OffSetEyeBrow/T-Minus-Case/README.md

# T-Minus-Case



Metalic Case for The E-ink smartwatch Yatchy.

Here you'll find in depth information to manufacture top and bottom case, internal spacers, isolating layers for the internals and buttons.

---

##  Repository Structure

Inside this repository i have made available blueprints with tolerances and GD&T, CAD, CAM and STLs Files, and manufactiring process specificiations for all parts. For purchased parts i will leave a link to purchase or get in contact with the given maker.

###  Parts List and Links:
*   **[Top Case](https://github.com/OffSetEyeBrow/T-Minus-Case/tree/main/Top%20Case):** Machined, containing files and instructions on production
*   **[Bottom Case](https://github.com/OffSetEyeBrow/T-Minus-Case/tree/main/Bottom%20Case):** Machined, containing files and instructions on production
*   **[Internal Spacers](https://github.com/OffSetEyeBrow/T-Minus-Case/tree/main/Internals):** 3D Printed (FDM), containing files and 3D printing parameters
*   **[Buttons](https://github.com/OffSetEyeBrow/T-Minus-Case/tree/main/Buttons):** 3D Printed (FDM), containing files and 3D printing parameters
*   **[Yatchy Board](https://github.com/OffSetEyeBrow/T-Minus-Case/wiki):** Link to the Github of the original creator, still getting updated at the moment of writing this
*   **[Watch Strap](https://github.com/OffSetEyeBrow/T-Minus-Case/wiki):** Purchased from Aliexpress, brushed stainless steel with butterfly lock

###  Other Parts of the Repository:

*   **[Assembly](https://github.com/OffSetEyeBrow/T-Minus-Case/tree/main/Assembly):** Assembly instructions and information, with info on used screws and parts
*   **[Post Processing](https://github.com/OffSetEyeBrow/T-Minus-Case/wiki):** Surface finishes, protective coatings and final steps of the process
---

##  Softwares and Machines used

The project has been designed and made with the following programs, tools and machines

| **CAD Software** | SolidWorks 2026 |
| :--- | :--- |
| **CAM Software** | TopSolid CAM 2026 |
| **CNC Machine** | Veker [forgot model lmao] (equipped with Siemens Sinumerik Panel) |
| **Slicer Software** | ORCA Slicer |
| **3D Printer** | Roided Up Ender 3 V2 (direct drive) |

---

## Materials Used

My personal T- Case has been made with the following materials:

*   **Devices for Machining:** Polyurethane Blocks
*   **Top & Bottom Cases:** Aluminum 5083 (Machined)
*   **Internal Spacers:** 95A TPU Filament (3D Printed)
*   **Buttons:** Transparent PLA Filament (3D Printed)

---

##  Related Projects & Ecosystem

*   **[Yatchy GitHub Repository](https://github.com/Szybet/Yatchy):** The main hardware board repository for the Yatchy.
*   **[InkWatchy GitHub Repository](https://github.com/Szybet/InkWatchy):** Recommended firmware and software for the watch.
  
---

##  Contacts

*   **[Linktr.ee](https://linktr.ee/offseteyebrow):** Linktr.ee page with links to all other pages of interest.
