OffSetEyeBrow/T-Minus-Case/Top Case/ProcessTC.md

# Top Case Machining

Top Case On Device

This guide covers the manufacturing process, fixture setup, material considerations, and tooling details required to machine the top watch case out of aluminum.

## Fixture Holes

The top case of the T-Minus watch case is a very thin piece (7mm thin), so holding it in a standard industrial sized CNC machine can prove to be challenging. To this end a modification of the CAD was made to allow 2 M3 Bolts to be passed through and tightened to a workholding piece machined out of Poliurethane with a fitting to the internal part of the case.

| Fixture | Adapted Work Piece | 
| ----- | ----- |
|  |  | 
| *[Device Top Case](https://github.com/OffSetEyeBrow/T-Minus-Case/blob/main/STEPs/Top%20Case.STEP)* | *Top Case Holes* | 

## Material

**Aluminum 5083** was chosen for the watch enclosure due to its relatively high availability, low price and great corrosion resistance:

* Generally considered "Naval Grade", which just means it's not too expensive and it has great corrosion resistance, so great choice to be in constant contact to skin oils. Only drawback I've noticed with use is its malleability, so it nicks and gets marked easily, anodization should help in this regard, as the outer layer gets higher hardness, so better resistance to wear and tear. 

* Main drawback of aluminum as case material: worsens signal strength for Bluetooth and WIFI antenna, so when updating the time and downloading weather, its best to keep it close to the internet modem.
  
* **Polyethylene** was chosen for the fixture because of its cheap price, ease to machine and malleability, having no risk to damage the surface of the case.

### Stock Dimensions: 

* For the top case a 10mm plate was chosen and cut to 70 x 48 mm to allow some room of error when squaring the work piece. in theory you could get a thinner plate, but it would need to be well squared and have decent surface finish as to be used directly in the machining steps

* For the fixture a 50x72x32mm block was used because it's what was available in the moment, but a shorter stock can easily be used, simply needing enough height to machine the fitting and having the space to hold the material in the vice.

## Tooling & Machining Parameters

Because of the small dimensions of the case and fixture, most of the tools used are on the smaller size, going down to a 1.7mm drill, and only up to a 20mm face mill for facing.

### Tool Table

| Tool ID | Tool Description | Diameter (mm) | Flutes | Primary Operation | Tool Image | 
| ----- | ----- | ----- | ----- | ----- | ----- |
| **T01** | Face Mill | 20mm | 4 Flutes | Stock Facing & Squaring |D20 Head| 
| **T02** | End Mill | 8mm | 2 Flutes | Roughing & Pocketing |D8 Top| 
| **T03*** | End Mill | 6mm | 2 Flutes | Roughing & Pocketing |D6 Top| 
| **T04** | End Mill | 4mm | 2 Flutes | Roughing & Finishing |D4 Top| 
| **T05**** | End Mill | 3mm | 2 Flutes | Finishing & Pocketing |D3 Top| 
| **T06** | End Mill | 2mm | 2 Flutes | Finishing & Slot Milling |D2 Top| 
| **T07** | Chamfer Mill (90°) | 4mm | 2 flutes | Chamfer Milling, Edge Deburring & Spot Drilling|D4 Chan| 
| **T08** | Twist Drill | 3.4mm | 2 Flutes | Fixture Holes Drilling |- Drill 3 4| 
| **T08** | Twist Drill | 2.5mm | 2 Flutes | Screw Holes Drilling |Drill 2 5| 
| **T10*****| Twist Drill | 1.7mm | 2 Flutes | Threaded Holes Drilling | **Manual Operation**  |
| **T11*****| Manual Tap  | M2 | ---- | 1.7mm Hole Threading | **Manual Operation**  |

--- 

### Footnotes:

* * The 6mm End Mill can be skippet by using the 8mm and the 4mm instead, leaving an extra tool slot and holder free.
* ** The 3mm End Mill wasn't actually used in any operation, but i would suggest it for slot milling instead of the 2mm, as its exactly the size of the gap for the top case fixture parts, and its smaller than the gap for the bottom case fixture parts. There are also other operations where the 2mm end mill can be replaced with the 3mm (but not all).
* *** Both the 1.7mm Drill and M2 Tap were used manually as i couldn't be bothered to program and make a whole other operation just for them, so i used them with a bench drill and tap drill respectively, but this could all be automated on the CNC machine.
