OffSetEyeBrow/T-Minus-Case/Bottom Case/Fixture Bottom Case.stp

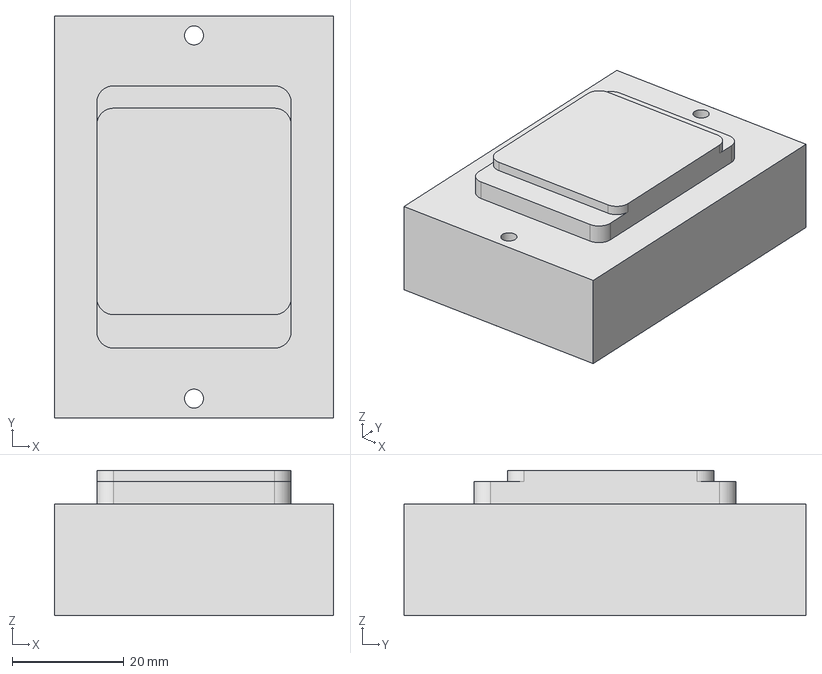
[picture p1: CAD file, 2026-10-20]
Bottom Case/Fixture Bottom Case.stp
50.0 x 72.0 x 26.0 mm
