OffSetEyeBrow/T-Minus-Case/Buttons/Button.STEP

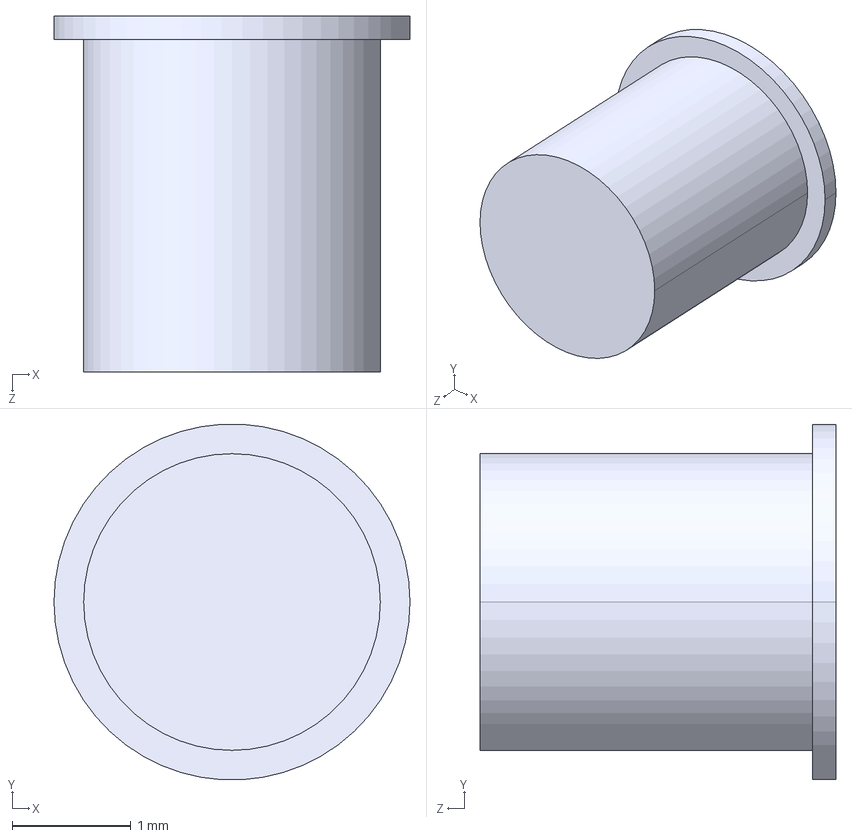
[picture p2: CAD file, 2026-10-19]
Buttons/Button.STEP
3.00 x 2.99 x 3.00 mm
