OffSetEyeBrow/T-Minus-Case/Internals/Mid Rubber.STEP

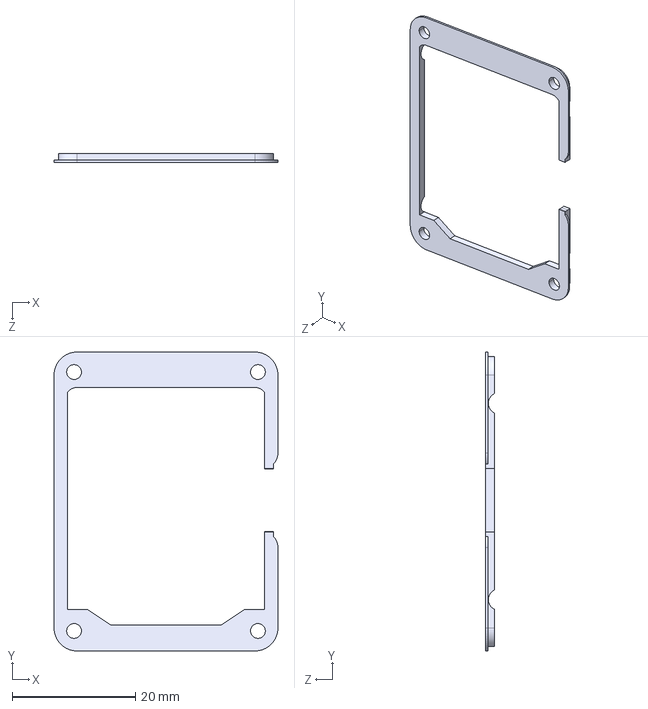
[picture p3: CAD file, 2026-10-19]
Internals/Mid Rubber.STEP
36.3 x 48.5 x 1.38 mm
