OffSetEyeBrow/T-Minus-Case/Top Case/Top Case With Fix Holes.step

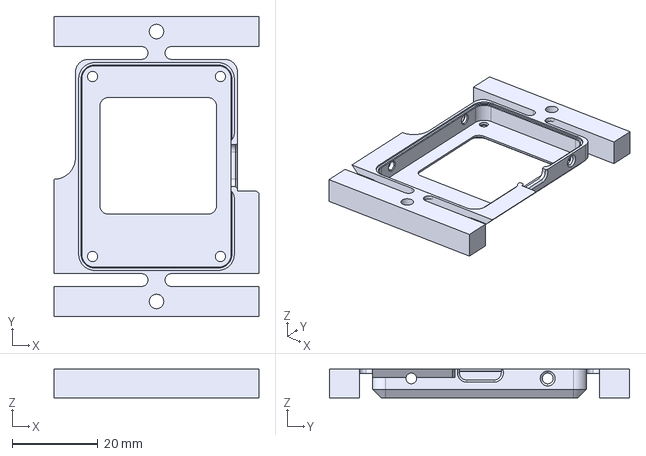
[picture p4: CAD file, 2026-10-20]
Top Case/Top Case With Fix Holes.step
47.8 x 70.0 x 6.71 mm
