OffSetEyeBrow/T-Minus-Case/Bottom Case/Bottom Case with Fix Holes.STEP

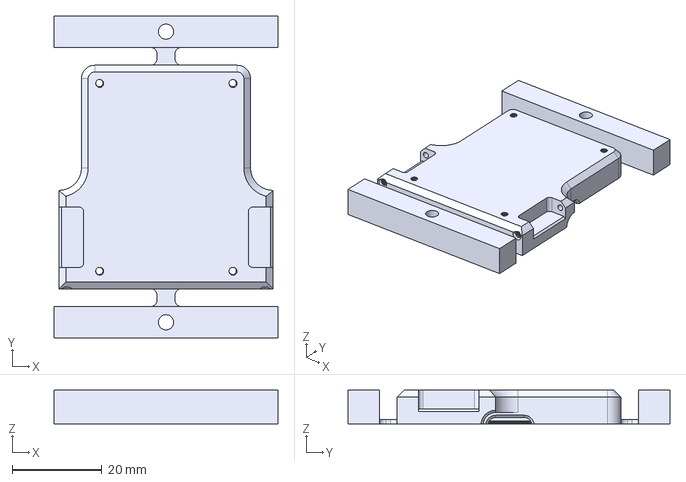
[picture p5: CAD file, 2026-10-20]
Bottom Case/Bottom Case with Fix Holes.STEP
50.0 x 72.0 x 7.50 mm
