OffSetEyeBrow/T-Minus-Case/Internals/Front Rubber A.STEP

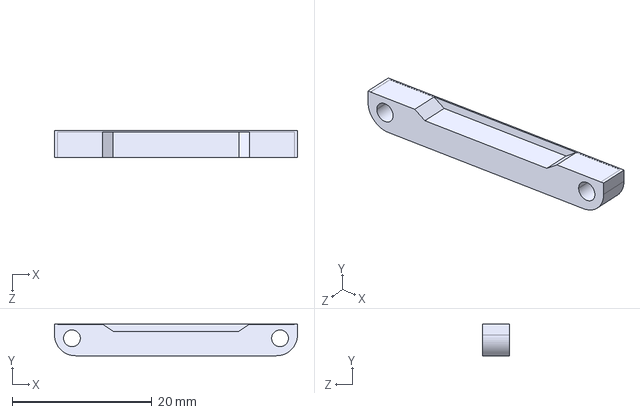
[picture p6: CAD file, 2026-10-19]
Internals/Front Rubber A.STEP
34.8 x 4.51 x 3.83 mm
