OffSetEyeBrow/T-Minus-Case/Top Case/Fixation Top Case.stp

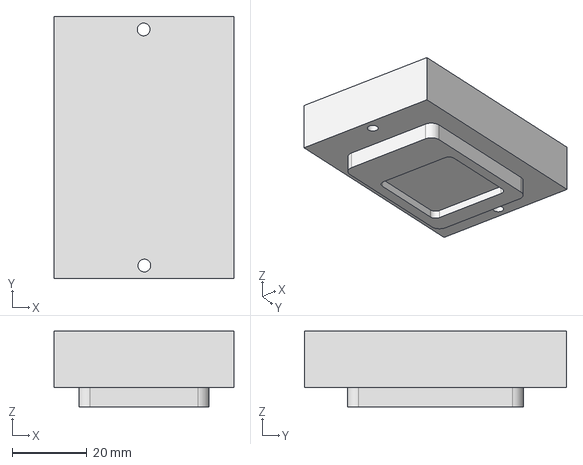
[picture p7: CAD file, 2026-10-20]
Top Case/Fixation Top Case.stp
48.0 x 70.0 x 20.2 mm
