OffSetEyeBrow/T-Minus-Case/Bottom Case/Bottom Case.STEP

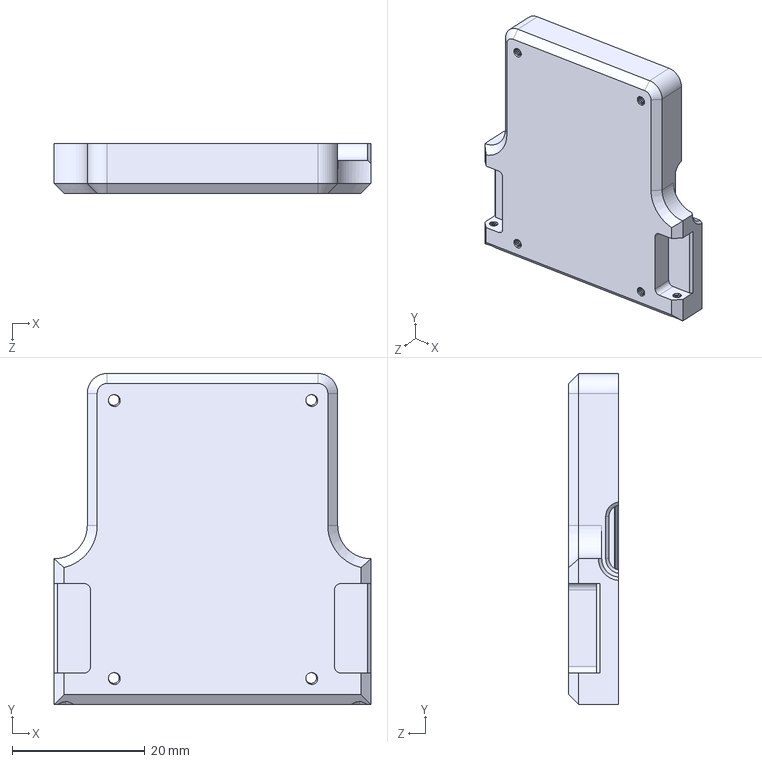
[picture p8: CAD file, 2026-10-19]
Bottom Case/Bottom Case.STEP
47.8 x 50.0 x 7.50 mm
