OffSetEyeBrow/T-Minus-Case/Internals/Rubber battery.STEP

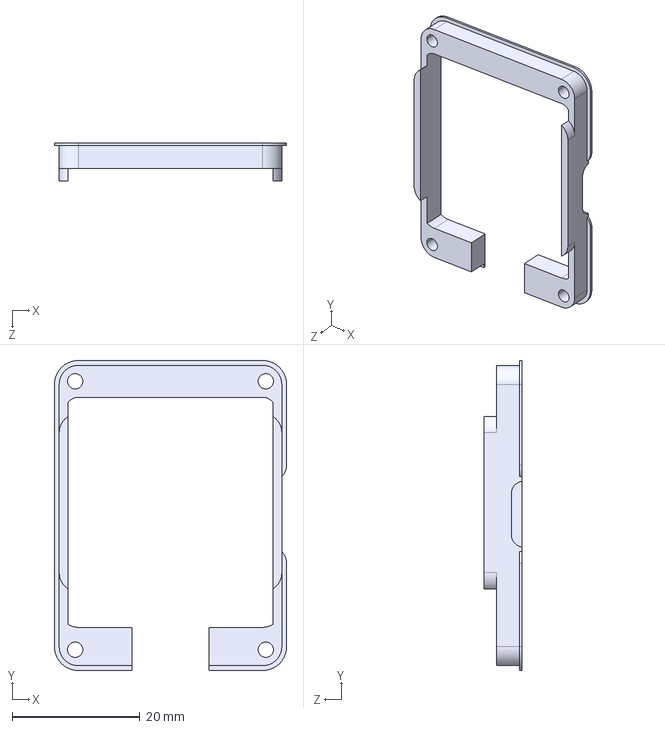
[picture p9: CAD file, 2026-10-19]
Internals/Rubber battery.STEP
36.3 x 48.5 x 6.00 mm
