OffSetEyeBrow/T-Minus-Case/Top Case/Top Case.STEP

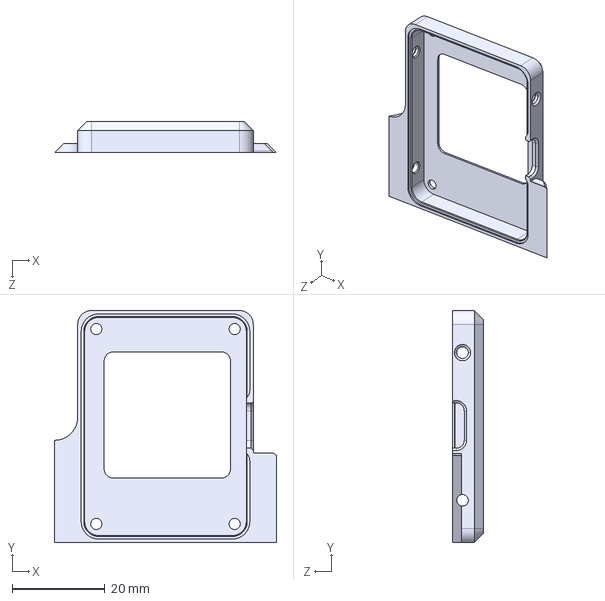
[picture p10: CAD file, 2026-10-19]
Top Case/Top Case.STEP
47.8 x 50.0 x 6.71 mm
