OffSetEyeBrow/T-Minus-Case/Internals/Front Rubber B.STEP

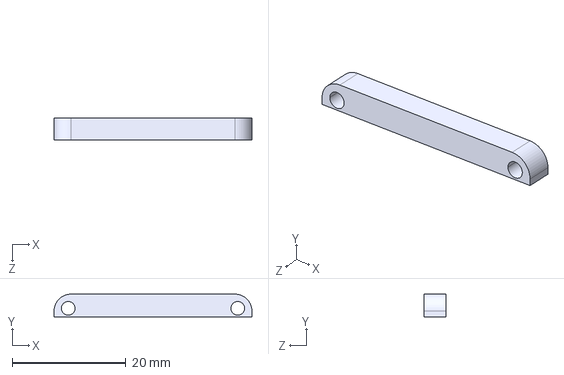
[picture p11: CAD file, 2026-10-19]
Internals/Front Rubber B.STEP
34.8 x 4.00 x 3.83 mm
