OffSetEyeBrow/T-Minus-Case/Assembly/BluePrint_EXP.PDF

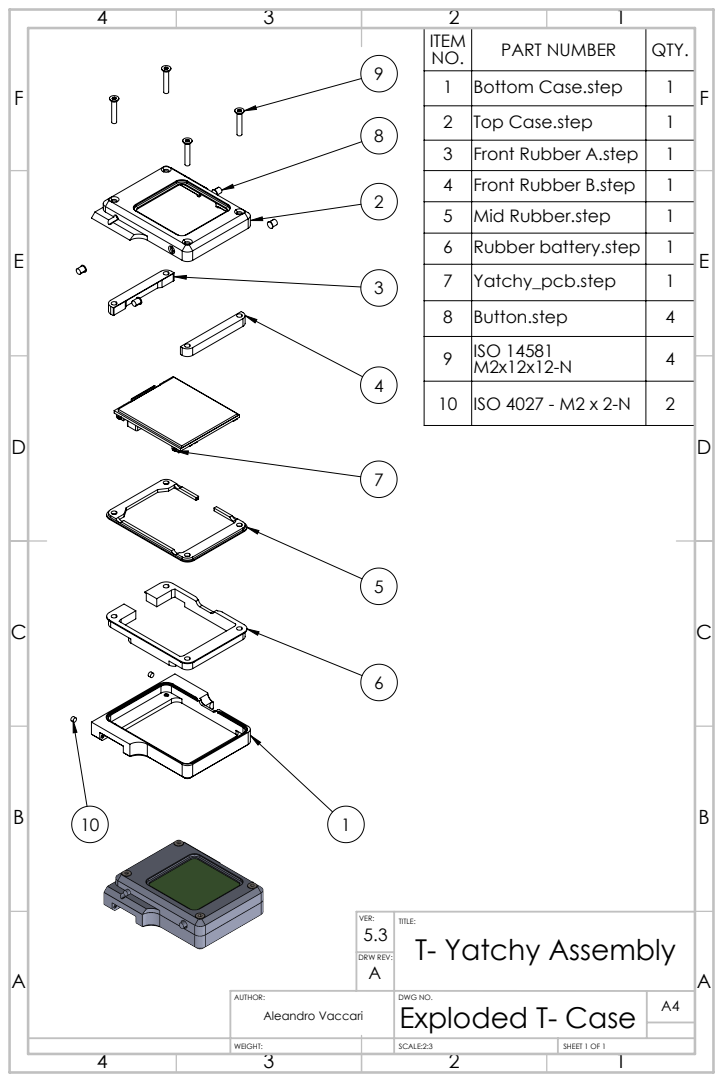
[picture p12: page 1]
DRW REV:

ITEM NO. | PART NUMBER | QTY.

1 | Bottom Case.step | 1
2 | Top Case.step | 1
3 | Front Rubber A.step | 1

E | | 4 | Front Rubber B.step | 1 | E

5 | Mid Rubber.step | 1
6 | Rubber battery.step | 1
7 | Yatchy_pcb.step | 1
8 | Button.step | 4
9 | ISO 14581 M2x12x12-N | 4

10 | ISO 4027 - M2 x 2-N | 2

VER: 5.3 | TITLE: T- Yatchy Assembly

AUTHOR: | DWG NO. Exploded T- Case | A4 Aleandro Vaccari

WEIGHT: | | SCALE:2:3 | SHEET 1 OF 1
