OffSetEyeBrow/T-Minus-Case/Bottom Case/BluePrint_BC.pdf

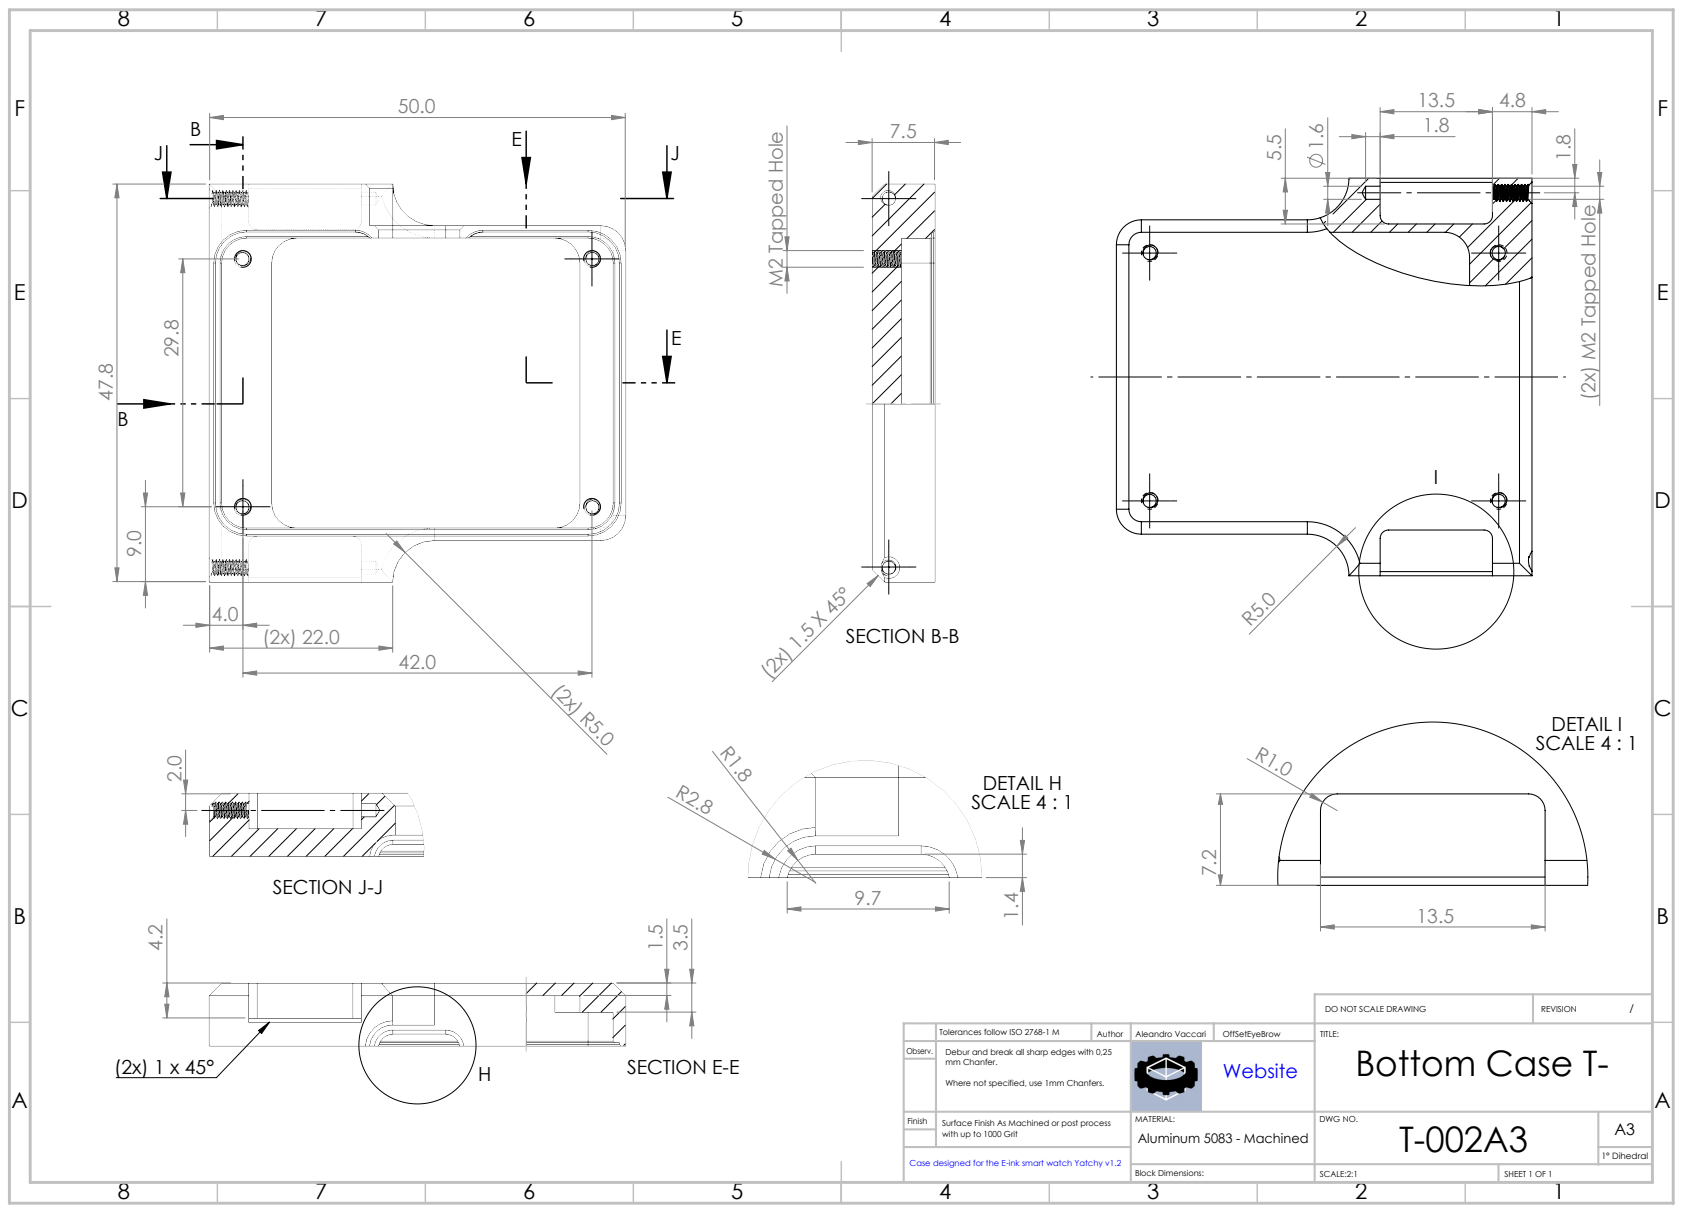
[picture p13: page 1]
(2x) M2 Tapped Hole; M2 Tapped Hole; SECTION B-B; SECTION E-E; DETAIL H SCALE 4 : 1; DETAIL I SCALE 4 : 1; SECTION J-J; DWG NO. A3 Aluminum 5083 - Machined

DO NOT SCALE DRAWING | REVISION /

Tolerances follow ISO 2768-1 M | Author | Aleandro Vaccari | OffSetEyeBrow | TITLE: Bottom Case T-

Observ. | Debur and break all sharp edges with 0,25 mm Chanfer. Where not specified, use 1mm Chanfers. | | Website (https://linktr.ee/offseteyebrow)

Surface Finish As Machined or post process
with up to 1000 Grit

Case designed for the E-ink smart watch Yatchy v1.2 (https://github.com/Szybet/Yatchy) | | | 1° Dihedral

Block Dimensions: | SCALE:2:1 | SHEET 1 OF 1
