OffSetEyeBrow/T-Minus-Case/Assembly/BluePrint_EXP.png

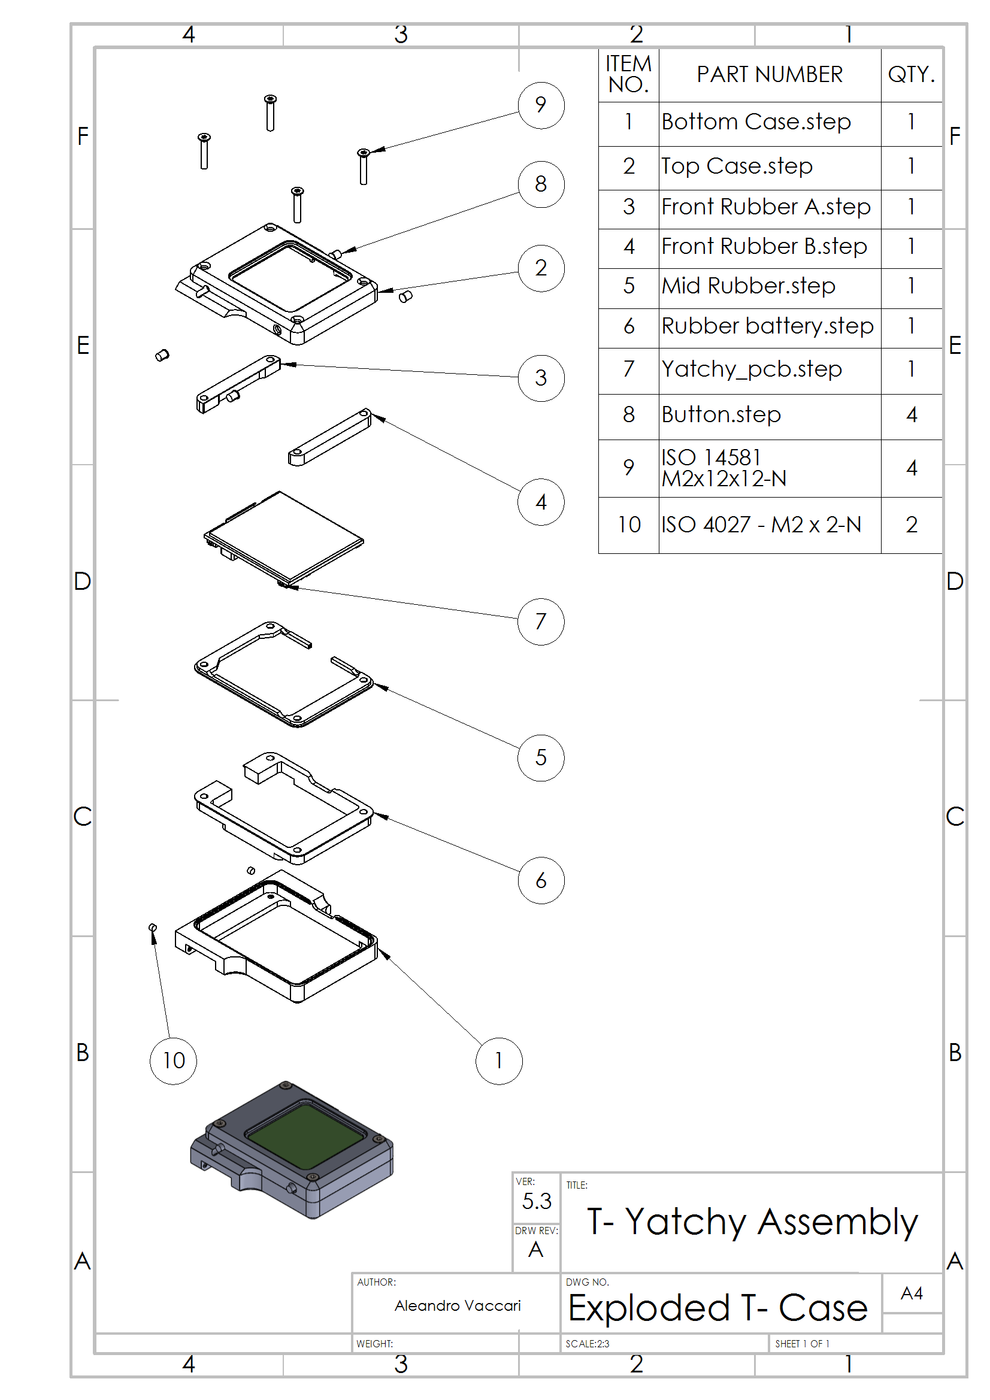
Assembly/BluePrint_EXP.png
