OffSetEyeBrow/T-Minus-Case/Bottom Case/BluePrint_BC.png

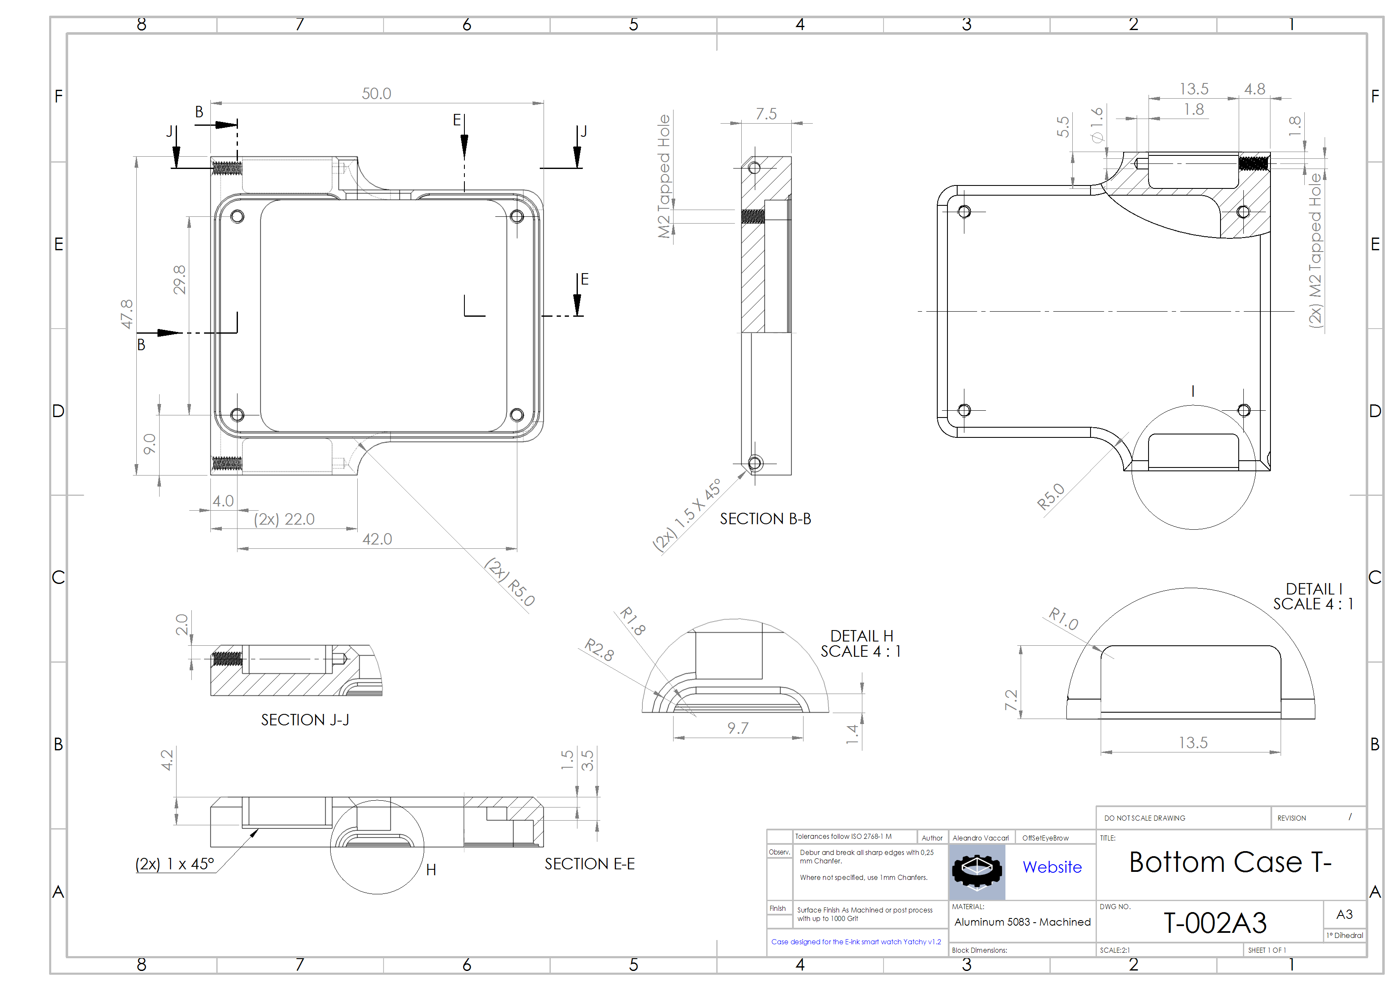
Bottom Case/BluePrint_BC.png
