OffSetEyeBrow/T-Minus-Case/Top Case/BluePrint_TC.png

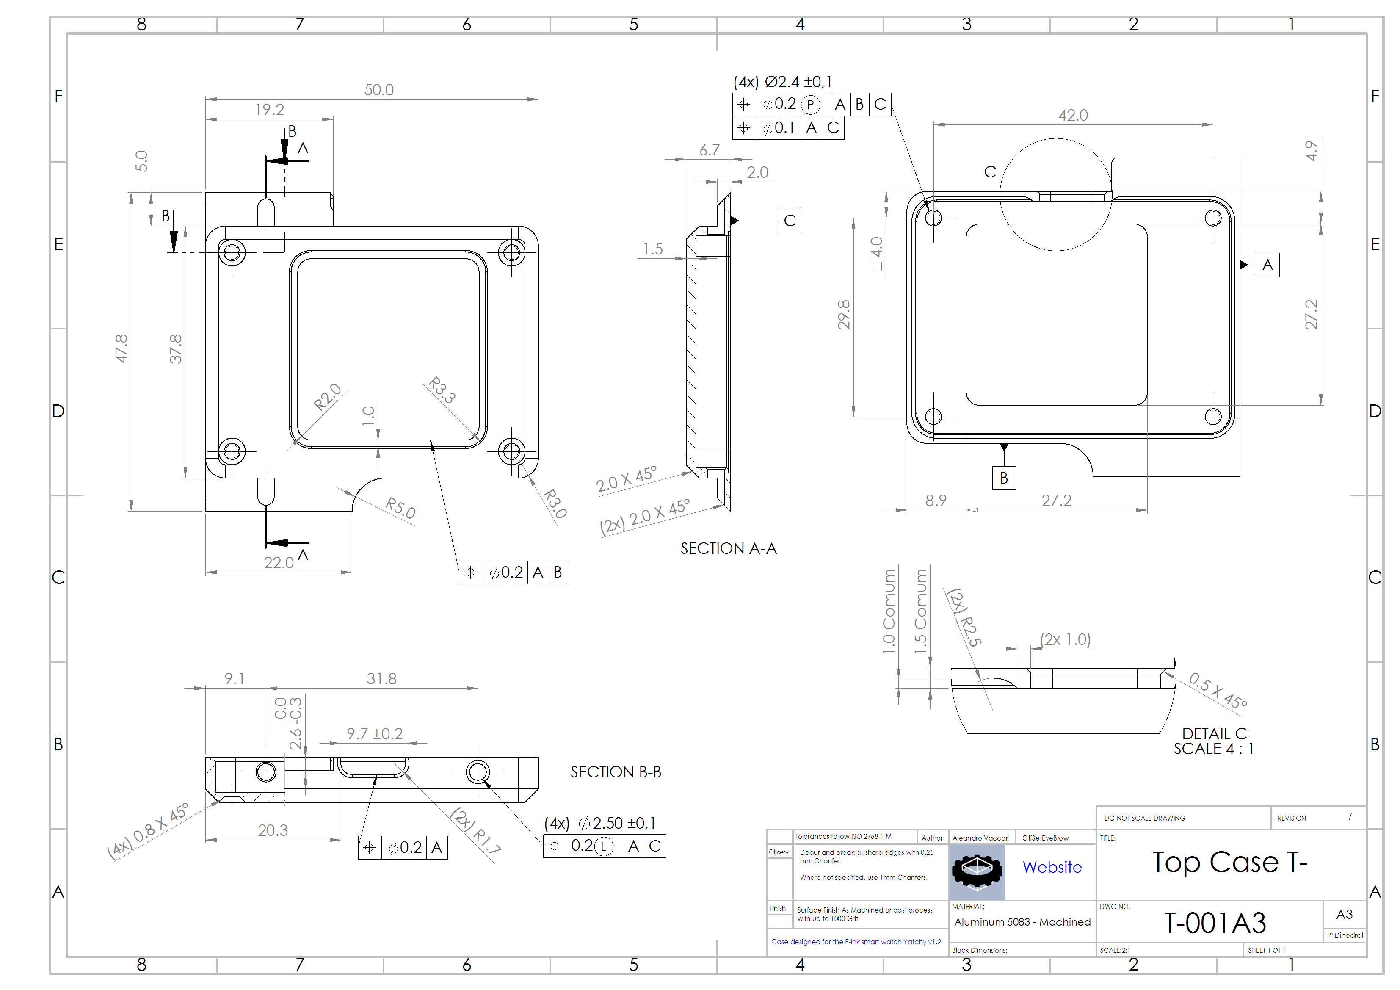
Top Case/BluePrint_TC.png
