OffSetEyeBrow/T-Minus-Case/(commit log)

2026-10-19 Added Step Files
    [Bottom Case.step.STEP, Button.step.STEP, Front Rubber A.step.STEP, Front Rubber B.step.STEP, Mid Rubber.step.STEP, Rubber battery.step.STEP, Top Case.step.STEP]
2026-10-19 Rename Bottom Case.step.STEP to Bottom Case.STEP
    [Bottom Case.STEP]
2026-10-19 Rename Front Rubber A.step.STEP to Front Rubber A.STEP
    [Front Rubber A.STEP]
2026-10-19 Rename Front Rubber B.step.STEP to Front Rubber B.STEP
    [Front Rubber B.STEP]
2026-10-19 Rename Mid Rubber.step.STEP to Mid Rubber.STEP
    [Mid Rubber.STEP]
2026-10-19 Rename Rubber battery.step.STEP to Rubber battery.STEP
    [Rubber battery.STEP]
2026-10-19 Rename Top Case.step.STEP to Top Case.STEP
    [Top Case.STEP]
2026-10-20 Added Main Folder Structure
    [Bottom Case.STEP, Button.STEP, Front Rubber A.STEP, Front Rubber B.STEP, Mid Rubber.STEP, Rubber battery.STEP, Top Case.step.STEP]
2026-10-20 Rename Top Case.pdf to BluePrint_TC.pdf
2026-10-20 Rename Top Case conv 1.png to BluePrint_TC.png
2026-10-20 Rename Bottom Case.pdf to BluePrint_BC.pdf
2026-10-20 Rename Bottom Case conv 1.png to BluePrint_BC.png
2026-10-20 Added Top Case Machining Versions
    [Fixation Top Case.stp, Top Case With Fix Holes.step]
2026-10-20 Fixture Bottom Case Files
    [Bottom Case with Fix Holes.STEP, Fixture Bottom Case.stp]
